raul-estevez/SimpleElectronicLoad/schematic/simpleelectronicload.sch

## KiCad design schematic/simpleelectronicload.sch (2021-07-05)

Schematic: simpleelectronicload.sch

Parts:
C1: 100uF
C2: 10n
C3: 10nF
D1: MBR20100CT; TO-247-3_Vertical
D2: 1N4007; D_DO-41_SOD81_P10.16mm_Horizontal
D3: approx. 2v
F1: Fuse
HS1: Heatsink_Pad
J1: Conn_01x02
MES1: Voltmeter_DC_30v
MES2: Amperemeter_DC_5A
NT1: Net-Tie_2
Q1: 2N7000; TO-92_Inline
Q2, Q3: IRF530; TO-220-3_Vertical
R1: 4k7
R2, R9, R10: 1k
R3, R12: 10k
R4, R13: 2k
R5, R7, R8: 100
R6: 2k2
R11: 0.1
R14: R
RV1, RV2, RV3: R_POT
SW1: SW_SPDT
TH1: NTC_4k7
U1: LM358
U2: TL431D; SOIC-8_3.9x4.9mm_P1.27mm

Notes on the sheet:
Simple Electronic Load
30/06/2021
1.0
Close to PSU & Output
INPUT & ERROR AMPLIFIER
POWER
FAN DRIVER
Absolute maximun ratings of this model: · 30v (voltmeter) · 5A (ampmeter) · 150W (limited time)
Calibration: · Turn RV2 until it reaches its maximun voltage. · Adjust RV3 until the ampmeter is at its maximun value.
To RV2
Alternative 1
Alternative 2
