raul-estevez/SimpleElectronicLoad/(commit log)

2021-07-05 Added circuit schematic
2021-07-05 Updated schematic colors
2021-07-05 Added part of the Function Principle and current equation
2021-07-05 Added BOM & BOM reference in README
2021-07-05 Added Temperature Limiting calibratio
2021-07-05 Added KiCAD project files
    [simpleelectronicload.sch]
